laneboysrc/hk310-expansion/hk310-rf-module.jpg

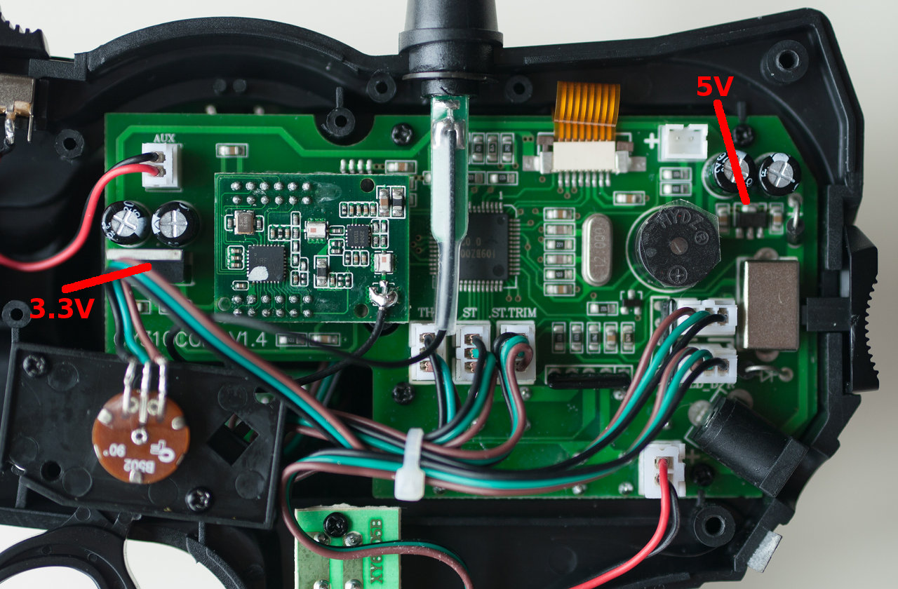
hk310-rf-module.jpg
