laneboysrc/hk310-expansion/(commit log)

2014-02-25 Add pin-out for NRF module
2014-02-26 Add first version of a filter app, modifying CH3
2014-02-26 Fix filter. Add correction re pulse vs number
    [value-vs-servo-pulse-duration-chart.ods]
2014-02-27 Add servo pulse measurement program (unfinished)
2014-02-28 Add calculation of tx-value vs expected received pulse
    [tx-value-vs-pulse-calculations.ods]
2014-03-01 Final version of how to calculate the TX value from a desired pulse duration
    [tx-value-vs-pulse-calculations.ods]
2014-03-01 Debugged and stabilized implementation
    [receiver-dump.py]
2014-03-01 First draft of oscillator calibration
    [pulse-measurement.c, servo-input.c, uart-output.c]
2014-03-01 Remove empirical value-vs-number spreadsheet
    [value-vs-servo-pulse-duration-chart.ods]
2014-03-01 Implement glitch removal, not tested yet
    [servo-input.c, uart-output.c]
2014-03-02 Add missing 0x10 test value
    [hk310-filter.py]
2014-03-02 Bugfix in sending the unsigned integer
    Also implement debug mode where we send raw timer values
    [servo-input.c, uart-output.c]
2014-03-02 Filter now works with repeating values 2 times only, plus new way of calculating values
2014-03-03 Implement proper oscillator calibration
    [pulse-measurement.c, servo-input.c, uart-output.c]
2014-03-03 Offset the pulse by 32us to avoid tiny pulses
    [hk310-filter.py, receiver-dump.py]
2014-03-04 Bugfix: wrong checksum was sent.
    Didn't matter as it is ignored anyway :(
    [hk310-filter.py]
2014-03-04 Add hk310-filter PIC firmware. Not complete and not tested.
2014-03-05 Start with a hardware test program.
    UART now has a proper header file.
2014-03-05 Increase averages to 4 so that glitches don't have a big impact
    [servo-input.c]
2014-03-10 Improve PIC version of hk310-filter
2014-03-10 Fix cleaned-up code, now everything is working fine
    [hk310-filter.py, receiver-dump.py]
2014-03-11 Add LEDs to show status
2014-03-11 Implement protocol decoding and drive LEDs. Working!
2014-03-12 Bugfix hk310-filter firmware, now working
    Both binary counter and keyboard are working fine
    [hk310-filter.c]
2014-03-12 Implement latching of keys to register short key presses
    [hk310-filter.c]
2014-03-13 Refactoring: make hk310-filter reusable. Make UART support multiple devices
2014-03-13 Add 3-position-switch source code
2014-03-19 Rename folders in preperation for Arduino name rules
2014-03-19 Add Arduino versions, not tested yet
2014-03-20 Fix APFCON register setting for Tx pin
    [main.c]
